RomanBych2019/StendPress_kompessor/display/Фон6.bmp

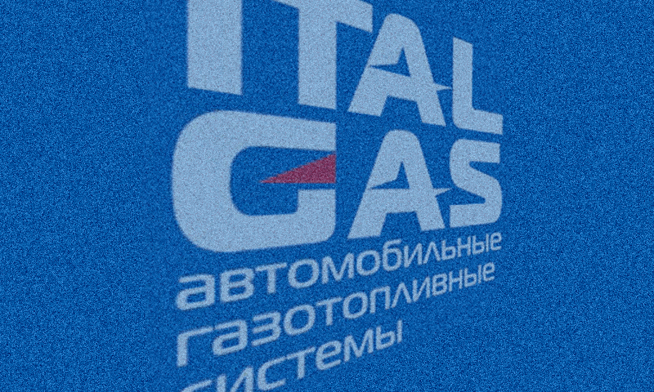
display/Фон6.bmp
