RomanBych2019/StendPress_kompessor/display/Фон7.bmp

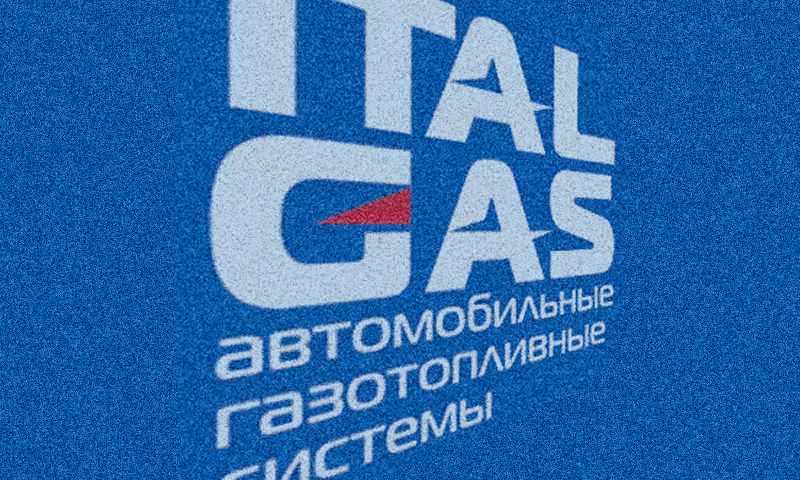
display/Фон7.bmp
