RomanBych2019/StendPress_kompessor/display/Датчик давления bad.bmp

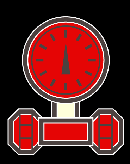
display/Датчик давления bad.bmp
