RomanBych2019/StendPress_kompessor/display/Датчик давления bad_b.bmp

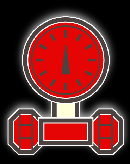
display/Датчик давления bad_b.bmp
