RomanBych2019/StendPress_kompessor/display/Датчик давления OK.bmp

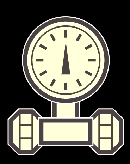
display/Датчик давления OK.bmp
