RomanBych2019/StendPress_kompessor/display/Клавиатура_2.bmp

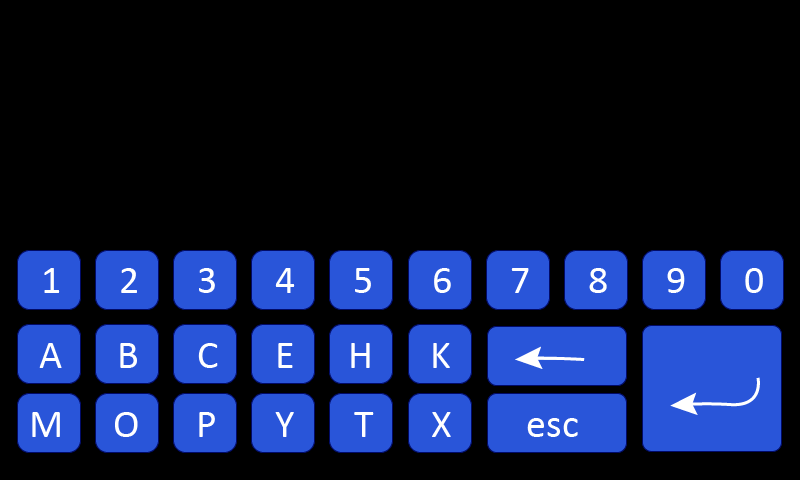
display/Клавиатура_2.bmp
