RomanBych2019/StendPress_kompessor/display/Клапан off.bmp

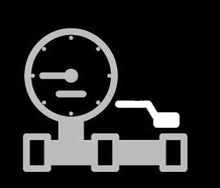
display/Клапан off.bmp
