RomanBych2019/StendPress_kompessor/display/Меню 1.bmp

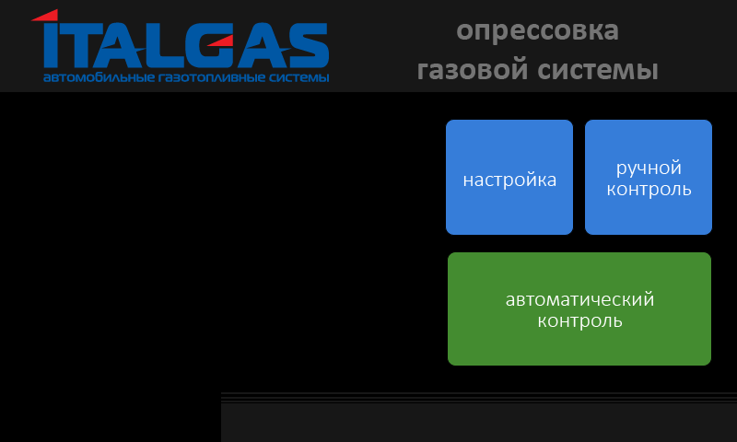
display/Меню 1.bmp
