RomanBych2019/StendPress_kompessor/display/Настройка.bmp

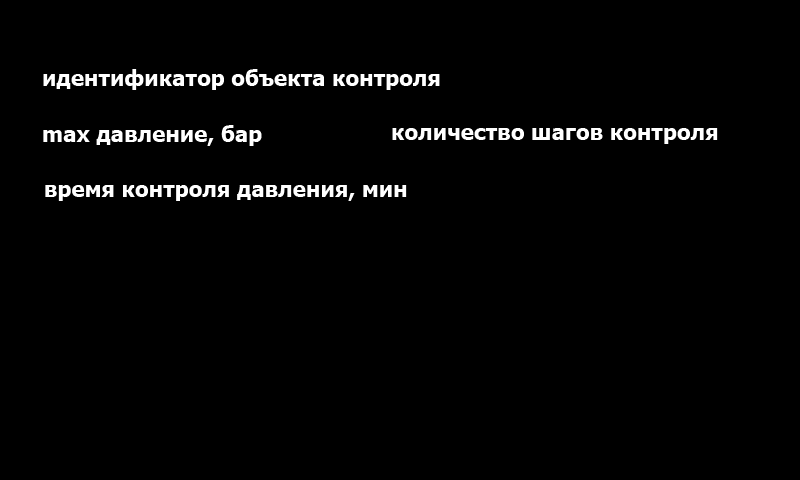
display/Настройка.bmp
