RomanBych2019/StendPress_kompessor/display/Опресовка 1.bmp

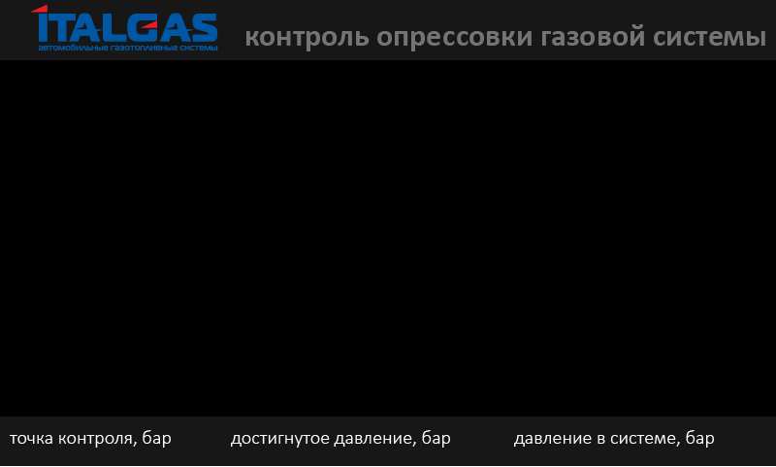
display/Опресовка 1.bmp
