RomanBych2019/StendPress_kompessor/display/Опресовка 1_ver2.bmp

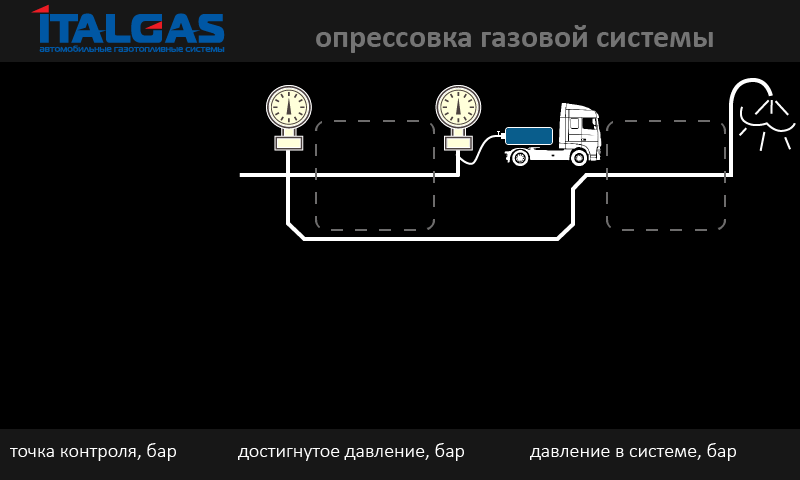
display/Опресовка 1_ver2.bmp
