RomanBych2019/StendPress_kompessor/display/Опресовка 2.bmp

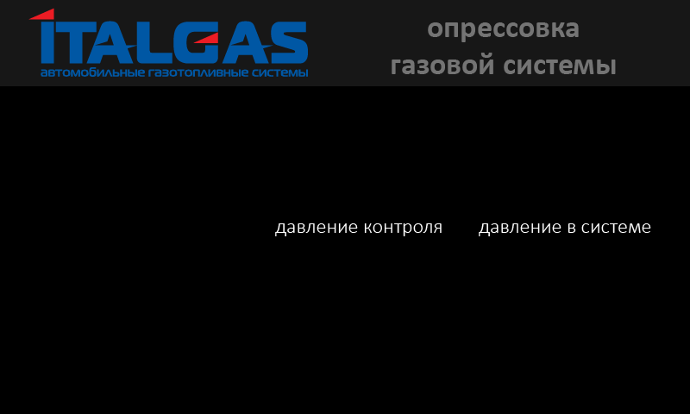
display/Опресовка 2.bmp
