RomanBych2019/StendPress_kompessor/display/Рессивер полный.bmp

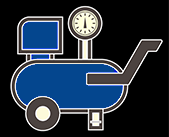
display/Рессивер полный.bmp
