RomanBych2019/StendPress_kompessor/display/Рессивер полный_on_b.bmp

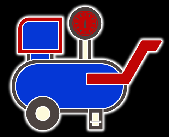
display/Рессивер полный_on_b.bmp
