RomanBych2019/StendPress_kompessor/display/Рессивер пустой.bmp

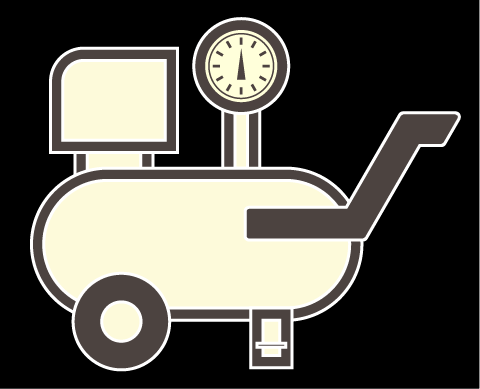
display/Рессивер пустой.bmp
