RomanBych2019/StendPress_kompessor/display/Рессивер пустой_b.bmp

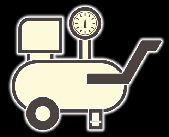
display/Рессивер пустой_b.bmp
