RomanBych2019/StendPress_kompessor/display/Фон1.bmp

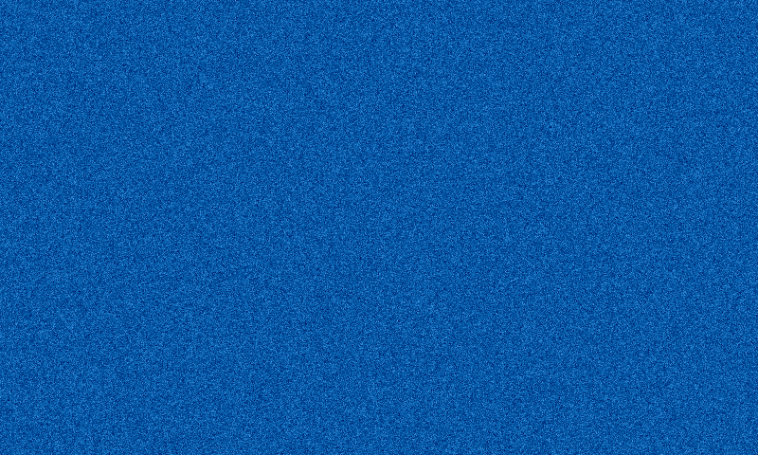
display/Фон1.bmp
