RomanBych2019/StendPress_kompessor/docs/IES-18.1.pdf

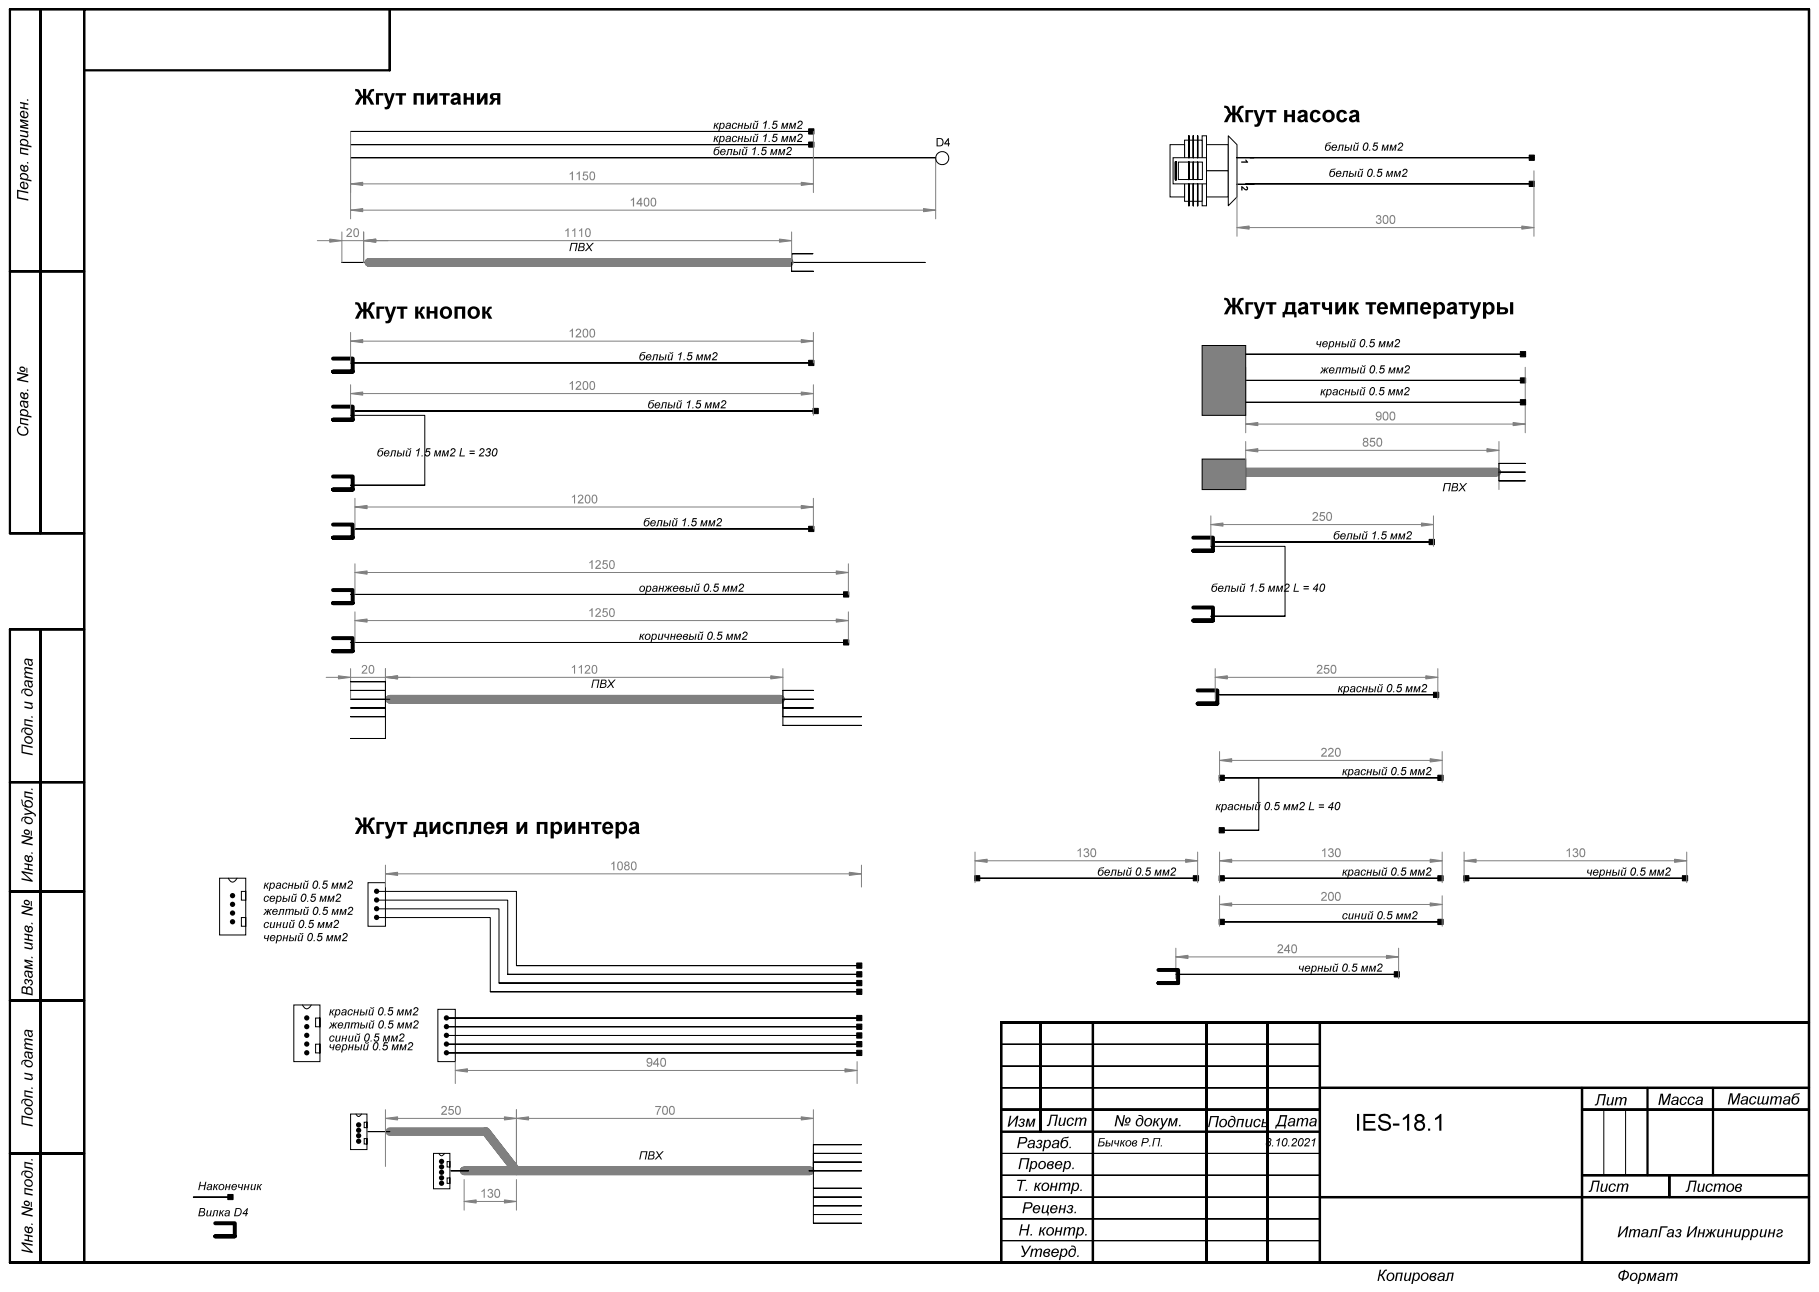
[picture p29: page 1]

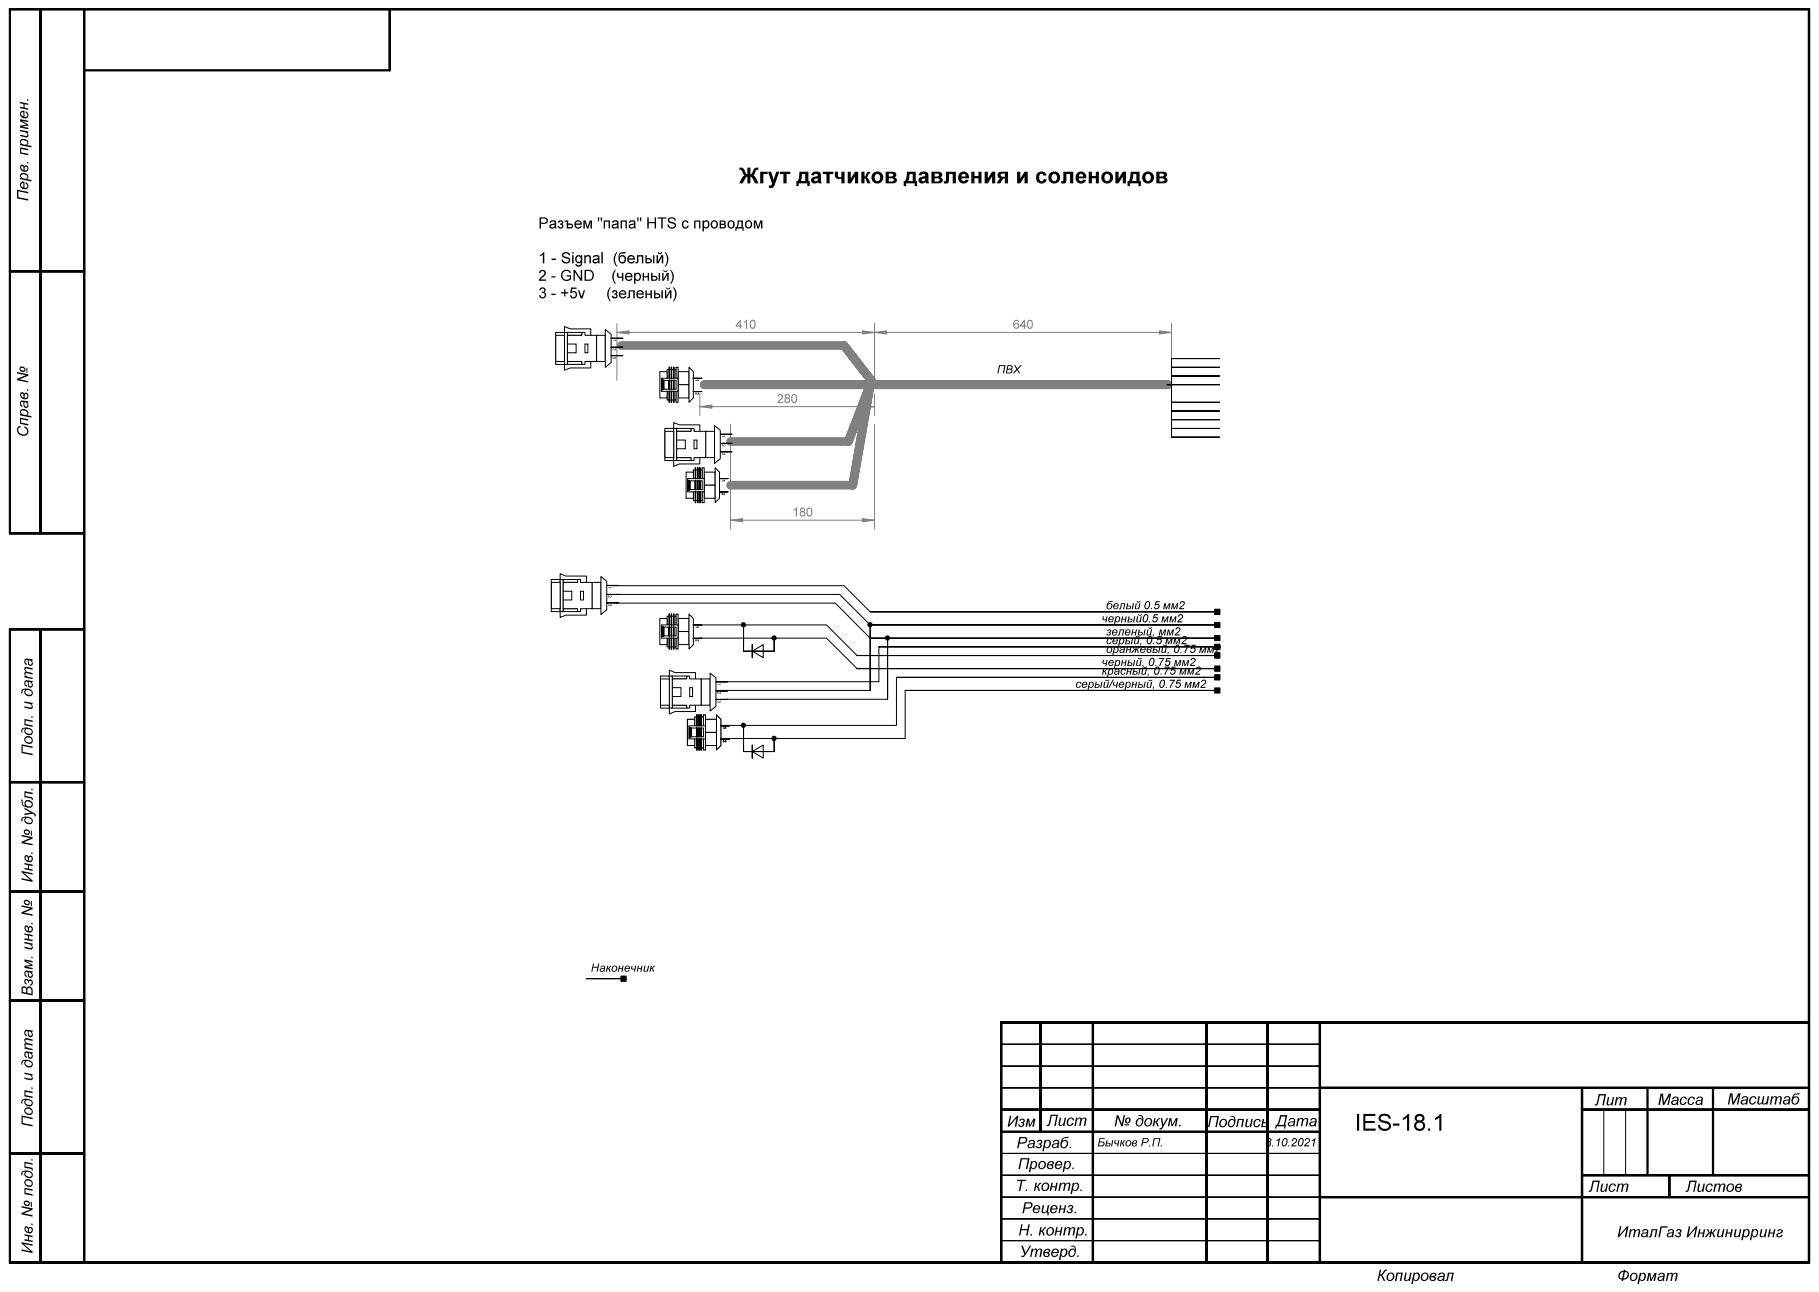
[picture p30: page 2]
