RomanBych2019/StendPress_kompessor/(list of files, drawings)

Other design files:
docs/Плата/Control_press_ver2_2022.lay6
docs/Стенд опрессовки с компрессором.spl7
