RomanBych2019/StendPress_kompessor/(commit log)

2022-01-29 Initial project version
    [Control_press.lay6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]
2022-01-29 Изменен новер весрии на 24, дата релиза
    [Стенд опрессовки с компрессором.spl7]
2022-01-29 Удалены лишние файлы
